nksb92/RLCV4/PCB/rlcv4/3V3.kicad_sch

## KiCad design PCB/rlcv4/3V3.kicad_sch (2026-04-22)

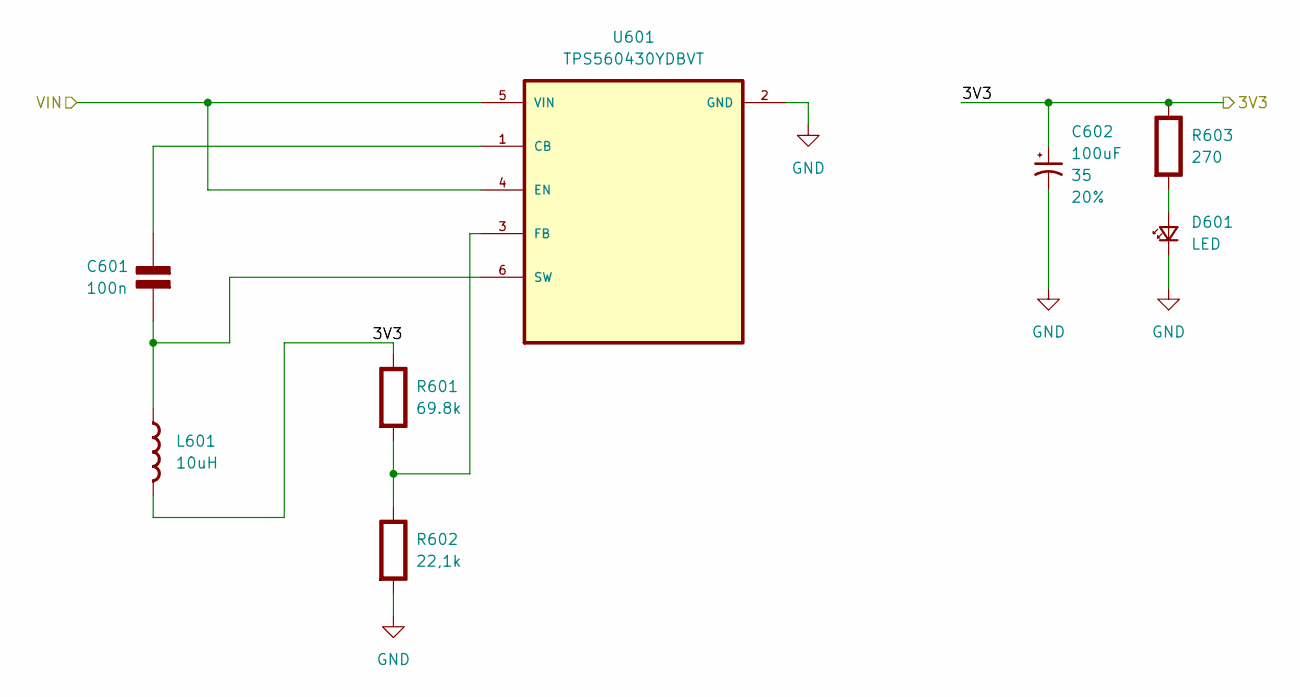
[picture p1: schematic 3V3.kicad_sch]

Parts:
C601: 100n; C_0805_2012Metric; Rating V
C602: 100uF; CP_Elec_8x6.5; Voltage 35; Tolerance 20%; Part Nmbr EDK107M035S9HAA
D601: LED; LED_0805_2012Metric; Part Nmbr LTST-C171GKT
L601: 10uH; L_Bourns_SRN6045TA; Rating A
R601: 69.8k; R_0805_2012Metric_Pad1.15x1.40mm_HandSolder; Rating W
R602: 22,1k; R_0805_2012Metric_Pad1.15x1.40mm_HandSolder; Rating W
R603: 270; R_0805_2012Metric_Pad1.15x1.40mm_HandSolder; Rating W
U601: TPS560430YDBVT; SOT95P280X145-6N

Connections:
3V3: C602.1, L601.2 (-), R601.1 (+), R603.1 (+)
GND: C602.2, D601.1 (K), R602.2 (-), U601.2 (GND)
unnamed: C601.1 (+), L601.1 (+), U601.6 (SW)
unnamed: C601.2 (-), U601.1 (CB)
unnamed: D601.2 (A), R603.2 (-)
unnamed: R601.2 (-), R602.1 (+), U601.3 (FB)
VIN: U601.4 (EN), U601.5 (VIN)
