nksb92/RLCV4/PCB/rlcv4/12V.kicad_sch

## KiCad design PCB/rlcv4/12V.kicad_sch (2026-04-22)

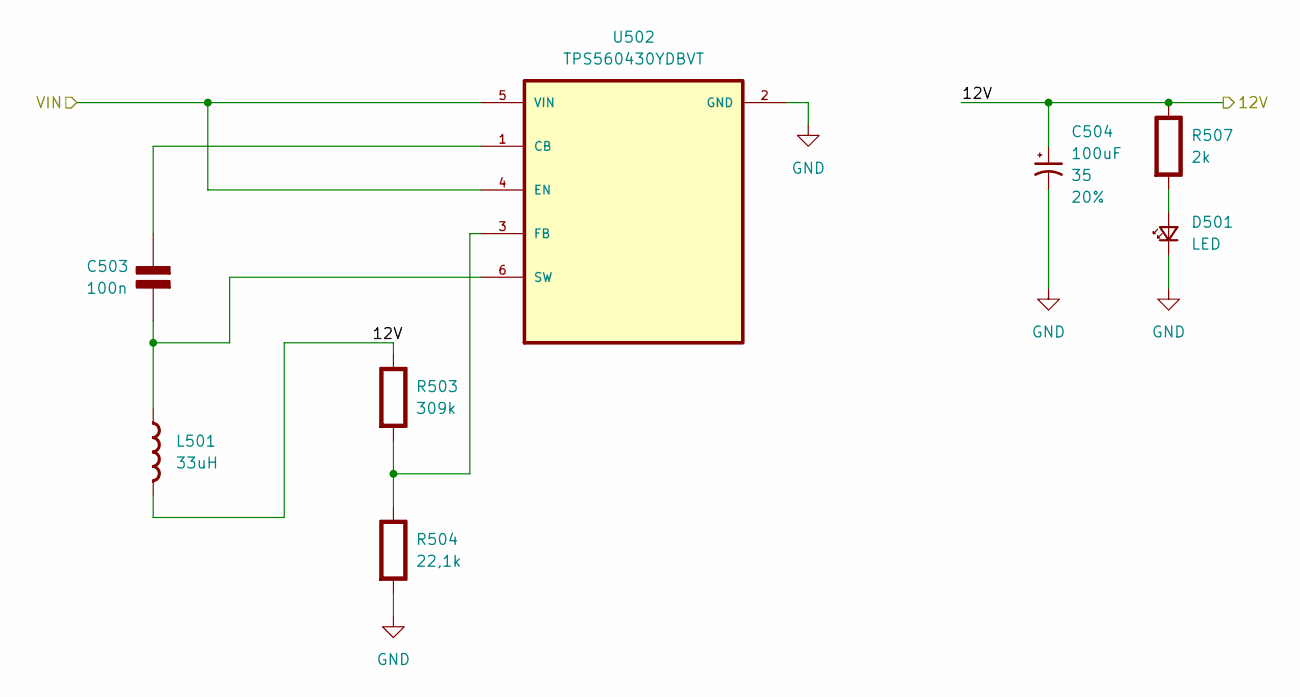
[picture p2: schematic 12V.kicad_sch]

Parts:
C503: 100n; C_0805_2012Metric; Rating V
C504: 100uF; CP_Elec_8x6.5; Voltage 35; Tolerance 20%; Part Nmbr EDK107M035S9HAA
D501: LED; LED_0805_2012Metric; Part Nmbr LTST-C171GKT
L501: 33uH; L_Bourns_SRN6045TA; Rating A
R503: 309k; R_0805_2012Metric_Pad1.15x1.40mm_HandSolder; Rating W
R504: 22,1k; R_0805_2012Metric_Pad1.15x1.40mm_HandSolder; Rating W
R507: 2k; R_0805_2012Metric_Pad1.15x1.40mm_HandSolder; Rating W
U502: TPS560430YDBVT; SOT95P280X145-6N

Connections:
12V: C504.1, L501.2 (-), R503.1 (+), R507.1 (+)
GND: C504.2, D501.1 (K), R504.2 (-), U502.2 (GND)
unnamed: C503.1 (+), L501.1 (+), U502.6 (SW)
unnamed: C503.2 (-), U502.1 (CB)
unnamed: D501.2 (A), R507.2 (-)
unnamed: R503.2 (-), R504.1 (+), U502.3 (FB)
VIN: U502.4 (EN), U502.5 (VIN)
