nksb92/RLCV4/PCB/rlcv4/DMX512.kicad_sch

## KiCad design PCB/rlcv4/DMX512.kicad_sch (2026-04-22)

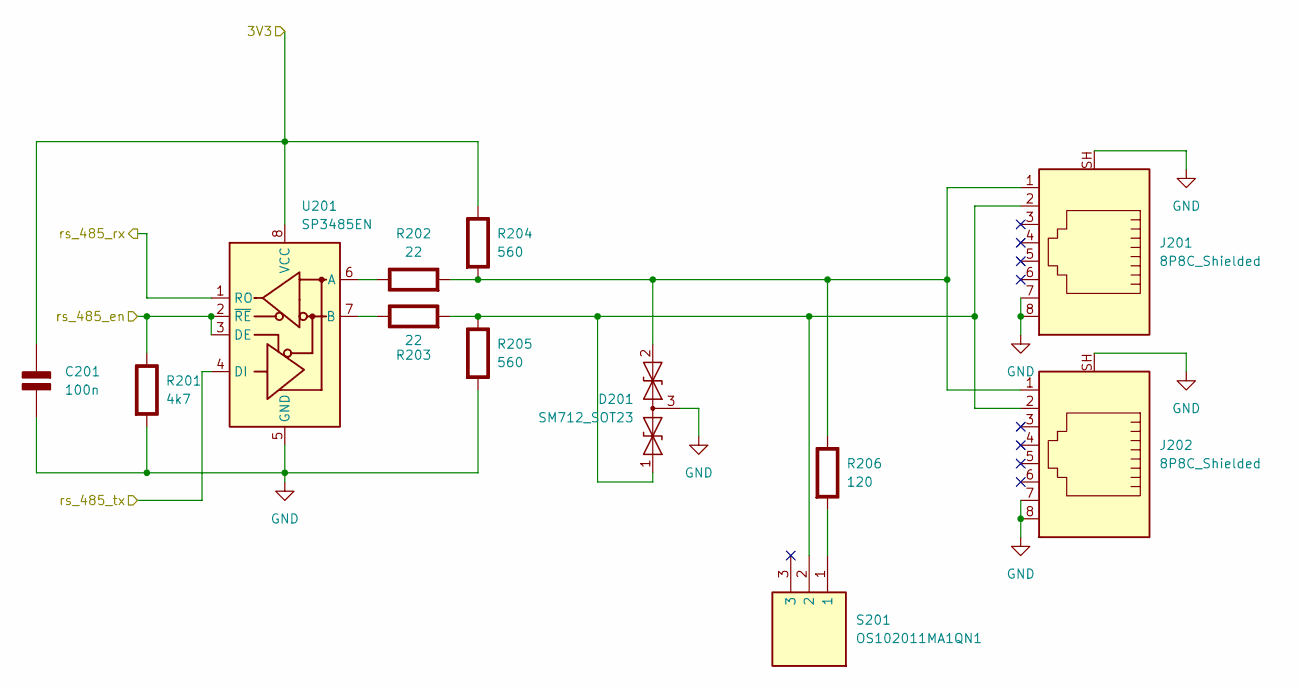
[picture p3: schematic DMX512.kicad_sch]

Parts:
C201: 100n; C_0805_2012Metric; Rating V
D201: SM712_SOT23; SOT-23
J201, J202: 8P8C_Shielded; RJ45_Ninigi_GE
R201: 4k7; R_0805_2012Metric_Pad1.15x1.40mm_HandSolder; Rating W
R202, R203: 22; R_0805_2012Metric_Pad1.15x1.40mm_HandSolder; Rating W
R204, R205: 560; R_0805_2012Metric_Pad1.15x1.40mm_HandSolder; Rating W
R206: 120; R_0805_2012Metric_Pad1.15x1.40mm_HandSolder; Rating W
S201: OS102011MA1QN1; SW_Slide_SPDT_Angled_CK_OS102011MA1Q; Mouser Part Number 611-OS102011MA1QN1
U201: SP3485EN; SOIC-8_3.9x4.9mm_P1.27mm

Connections:
3V3: C201.2 (-), R204.1 (+), U201.8 (VCC)
GND: C201.1 (+), D201.3 (common), J201.7, J201.8, J201.SH, J202.7, J202.8, J202.SH, R201.2 (-), R205.2 (-), U201.5 (GND)
unnamed: D201.1 (A1), J201.2, J202.2, R203.2 (-), R205.1 (+), S201.2
unnamed: D201.2 (A2), J201.1, J202.1, R202.2 (-), R204.2 (-), R206.1 (+)
unnamed: R202.1 (+), U201.6 (A)
unnamed: R203.1 (+), U201.7 (B)
unnamed: R206.2 (-), S201.1
rs_485_en: R201.1 (+), U201.2 (~RE), U201.3 (DE)
rs_485_rx: U201.1 (RO)
rs_485_tx: U201.4 (DI)
