nksb92/RLCV4/PCB/rlcv4/fan.kicad_sch

## KiCad design PCB/rlcv4/fan.kicad_sch (2026-04-22)

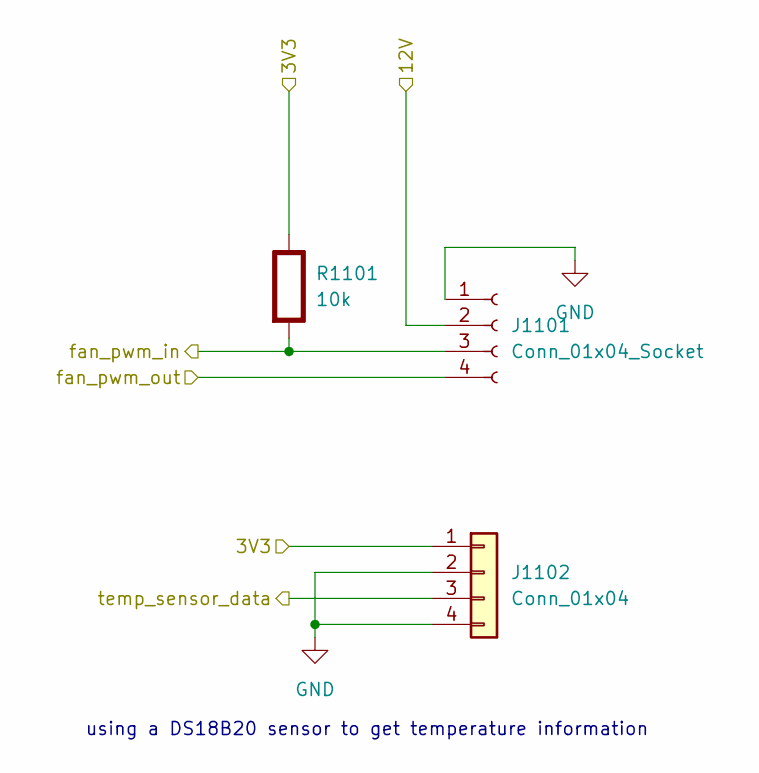
[picture p4: schematic fan.kicad_sch]

Parts:
J1101: Conn_01x04_Socket; FanPinHeader_1x04_P2.54mm_Vertical
J1102: Conn_01x04; JST_PH_B4B-PH-K_1x04_P2.00mm_Vertical
R1101: 10k; R_0805_2012Metric_Pad1.15x1.40mm_HandSolder; Rating W

Connections:
3V3: J1102.1, R1101.1 (+)
12V: J1101.2
GND: J1101.1, J1102.2, J1102.4
fan_pwm_in: J1101.3, R1101.2 (-)
fan_pwm_out: J1101.4
temp_sensor_data: J1102.3

Notes on the sheet:
using a DS18B20 sensor to get temperature information
