nksb92/RLCV4/PCB/rlcv4/led.kicad_sch

## KiCad design PCB/rlcv4/led.kicad_sch (2026-04-22)

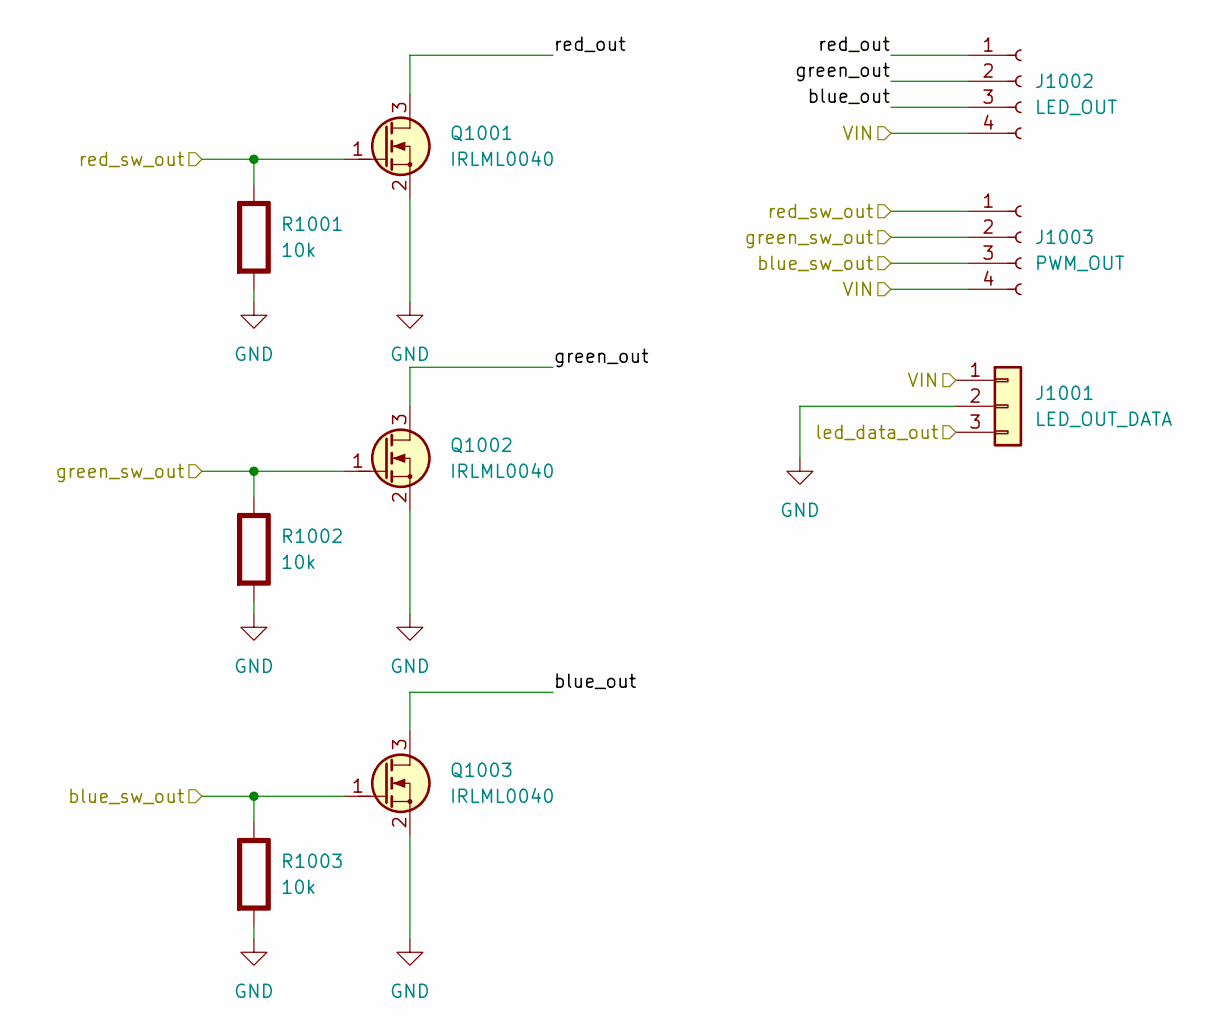
[picture p5: schematic led.kicad_sch]

Parts:
J1001: LED_OUT_DATA; Molex_Sabre_43160-0103_1x03_P7.49mm_Vertical_ThermalVias
J1002: LED_OUT; PhoenixContact_MCV_1,5_4-G-5.08_1x04_P5.08mm_Vertical
J1003: PWM_OUT; Wuerth_WR-WTB_64800411622_1x04_P1.50mm_Vertical
Q1001, Q1002, Q1003: IRLML0040; SOT-23
R1001, R1002, R1003: 10k; R_0805_2012Metric_Pad1.15x1.40mm_HandSolder; Rating W

Connections:
GND: J1001.2, Q1001.2 (S), Q1002.2 (S), Q1003.2 (S), R1001.2 (-), R1002.2 (-), R1003.2 (-)
VIN: J1001.1, J1002.4, J1003.4
blue_out: J1002.3, Q1003.3 (D)
blue_sw_out: J1003.3, Q1003.1 (G), R1003.1 (+)
green_out: J1002.2, Q1002.3 (D)
green_sw_out: J1003.2, Q1002.1 (G), R1002.1 (+)
led_data_out: J1001.3
red_out: J1002.1, Q1001.3 (D)
red_sw_out: J1003.1, Q1001.1 (G), R1001.1 (+)
