nksb92/RLCV4/PCB/rlcv4/mcu.kicad_sch

## KiCad design PCB/rlcv4/mcu.kicad_sch (2026-04-22)

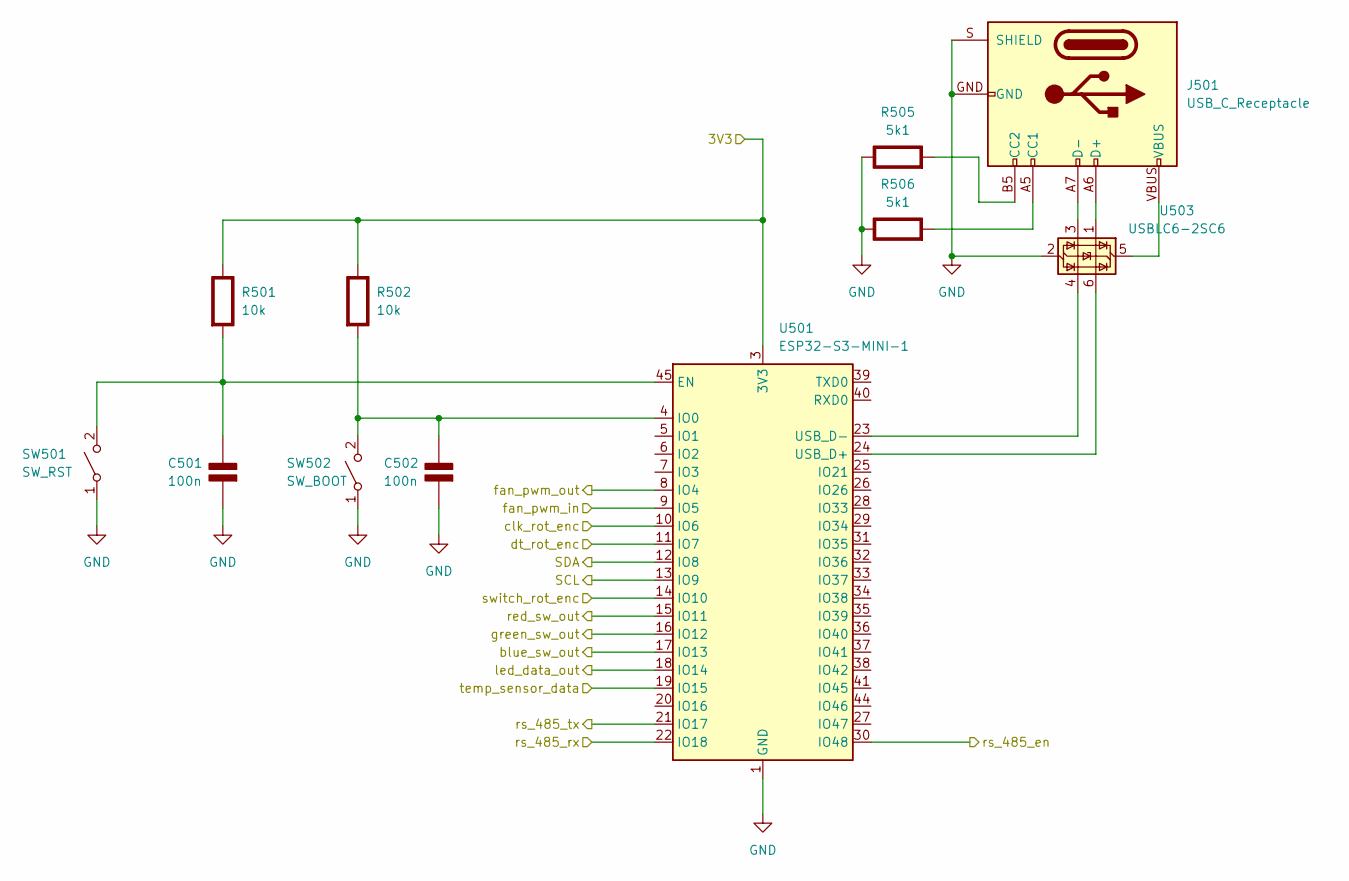
[picture p6: schematic mcu.kicad_sch]

Parts:
C501, C502: 100n; C_0805_2012Metric; Rating V
J501: USB_C_Receptacle; USB-C_16; Part Nmbr UJ20-C-H-G-SMT-1A-P16-TR
R501, R502: 10k; R_0805_2012Metric_Pad1.15x1.40mm_HandSolder; Rating W
R505, R506: 5k1; R_0805_2012Metric_Pad1.15x1.40mm_HandSolder; Rating W
SW501: SW_RST; SW_SPST_Omron_B3FS-105xP; Part Nmbr STO-060A16AB
SW502: SW_BOOT; SW_SPST_Omron_B3FS-105xP; Part Nmbr STO-060A16AB
U501: ESP32-S3-MINI-1; ESP32-S2-MINI-1
U503: USBLC6-2SC6; SOT-23-6_BigPads

Connections:
3V3: R501.1 (+), R502.1 (+), U501.3 (3V3)
GND: C501.1 (+), C502.1 (+), J501.GND, J501.S (SHIELD), R505.1 (+), R506.1 (+), SW501.1 (A), SW502.1 (A), U501.1 (GND), U501.2 (GND), U501.42 (GND), U501.43 (GND), U501.46 (GND), U501.47 (GND), U501.48 (GND), U501.49 (GND), U501.50 (GND), U501.51 (GND), U501.52 (GND), U501.53 (GND), U501.54 (GND), U501.55 (GND), U501.56 (GND), U501.57 (GND), U501.58 (GND), U501.59 (GND), U501.60 (GND), U501.61 (GND), U501.62 (GND), U501.63 (GND), U501.64 (GND), U501.65 (GND), U503.2 (GND)
unnamed: C501.2 (-), R501.2 (-), SW501.2 (B), U501.45 (EN)
unnamed: C502.2 (-), R502.2 (-), SW502.2 (B), U501.4 (IO0)
unnamed: J501.A5 (CC1), R506.2 (-)
unnamed: J501.A6 (D+), J501.B6 (D+), U503.1 (I/O1)
unnamed: J501.A7 (D-), J501.B7 (D-), U503.3 (I/O2)
unnamed: J501.B5 (CC2), R505.2 (-)
unnamed: J501.VBUS, U503.5 (VBUS)
unnamed: U501.23 (USB_D-), U503.4 (I/O2)
unnamed: U501.24 (USB_D+), U503.6 (I/O1)
SCL: U501.13 (IO9)
SDA: U501.12 (IO8)
blue_sw_out: U501.17 (IO13)
clk_rot_enc: U501.10 (IO6)
dt_rot_enc: U501.11 (IO7)
fan_pwm_in: U501.9 (IO5)
fan_pwm_out: U501.8 (IO4)
green_sw_out: U501.16 (IO12)
led_data_out: U501.18 (IO14)
red_sw_out: U501.15 (IO11)
rs_485_en: U501.30 (IO48)
rs_485_rx: U501.22 (IO18)
rs_485_tx: U501.21 (IO17)
switch_rot_enc: U501.14 (IO10)
temp_sensor_data: U501.19 (IO15)
