nksb92/RLCV4/PCB/rlcv4/oled_display.kicad_sch

## KiCad design PCB/rlcv4/oled_display.kicad_sch (2026-04-22)

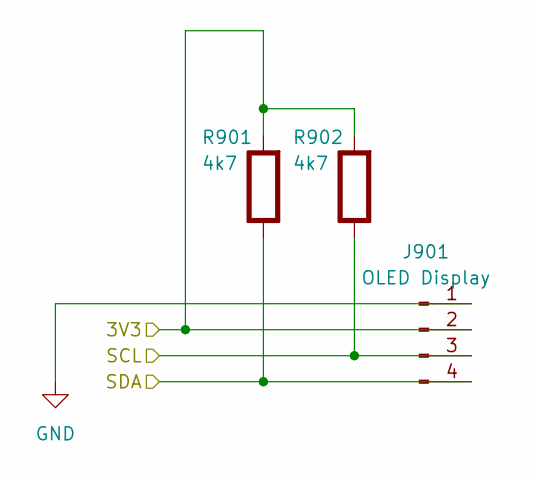
[picture p7: schematic oled_display.kicad_sch]

Parts:
J901: OLED Display; PinSocket_1x04_P2.54mm_Vertical
R901, R902: 4k7; R_0805_2012Metric_Pad1.15x1.40mm_HandSolder; Rating W

Connections:
3V3: J901.2, R901.2 (-), R902.2 (-)
GND: J901.1
SCL: J901.3, R902.1 (+)
SDA: J901.4, R901.1 (+)
