nksb92/RLCV4/PCB/rlcv4/power.kicad_sch

## KiCad design PCB/rlcv4/power.kicad_sch (2026-04-22)

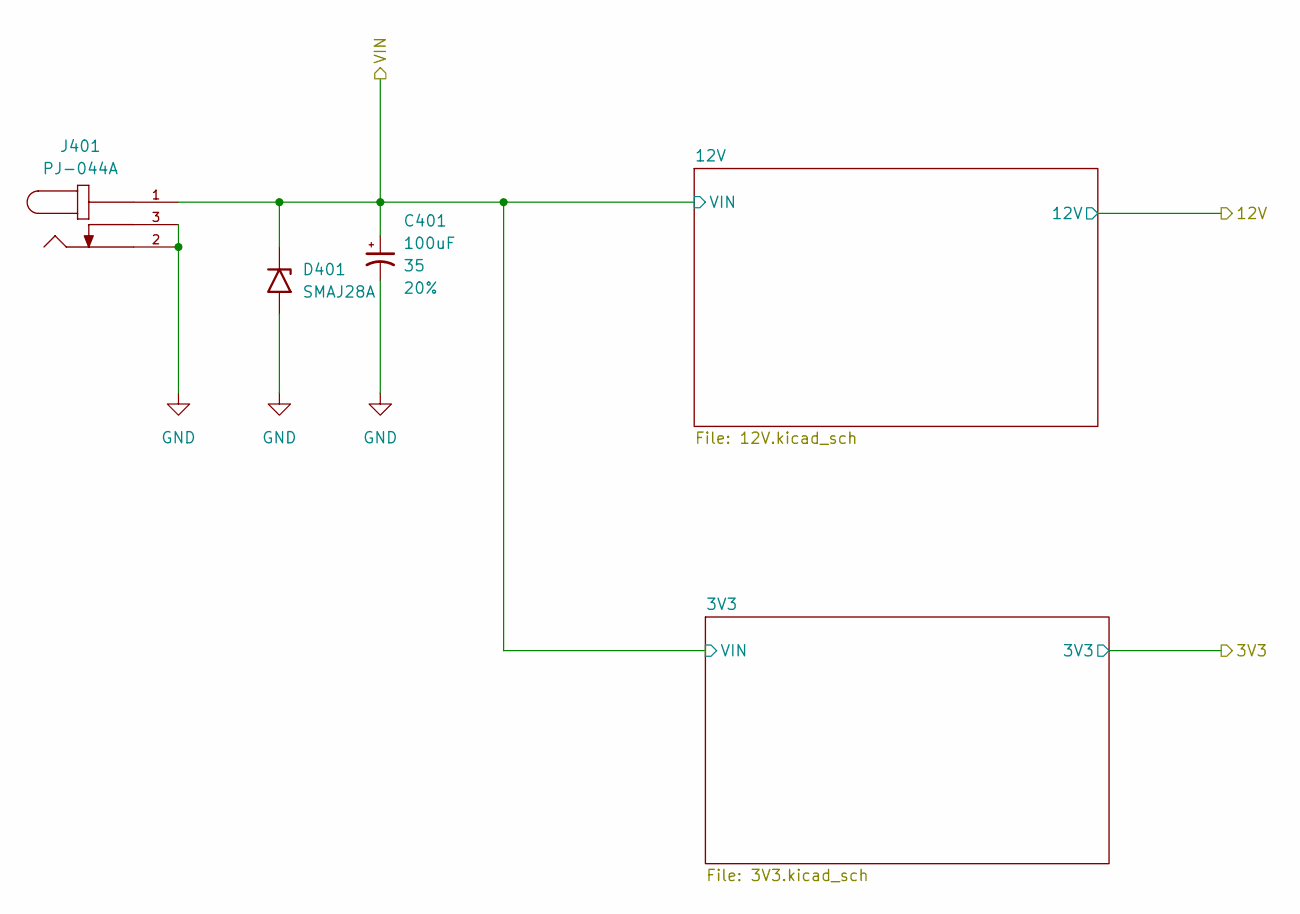
[picture p8: schematic power.kicad_sch]

Parts:
C401: 100uF; CP_Elec_8x6.5; Voltage 35; Tolerance 20%; Part Nmbr EDK107M035S9HAA
D401: SMAJ28A; D_SMAFL
J401: PJ-044A; CUI_PJ-044A; PARTREV 1.02

Connections:
GND: C401.2, D401.2 (A2), J401.2, J401.3
VIN: C401.1, D401.1 (A1), J401.1
