nksb92/RLCV4/(commit log)

2026-04-22 Add KiCad PCB and schematic design files
    [12V.kicad_sch, 3V3.kicad_sch, DMX512.kicad_sch, fan.kicad_sch, led.kicad_sch, mcu.kicad_sch, oled_display.kicad_sch, power.kicad_sch]
2026-04-22 Add ESP32-S3-DevKitM-1 reference schematic PDF
2026-04-27 Restyle LaTeX docs: Frost color palette, custom Pygments theme, 2-space indent
    - Switch body font to Helvetica/Inconsolata; replace mathptmx
    - Define FrostBg/Flame/FrostKw color palette; replace gray!5 across all
    circuitikz diagrams in system, software, and hardware sections
    - Add custom rlcv4 Pygments style package and wire up \usemintedstyle{rlcv4}
    - Reformat all minted code blocks to 2-space indentation (Google C++ style)
    - Rename sacn_source_t::last_packet_ms → last_pkt_ms for consistency
    - Fix double-buffer diagram arrows and adjust node positions
